ndevenish/PWMControl/Adv_PWM.kicad_pcb

## KiCad design Adv_PWM.kicad_pcb (2017-04-24)

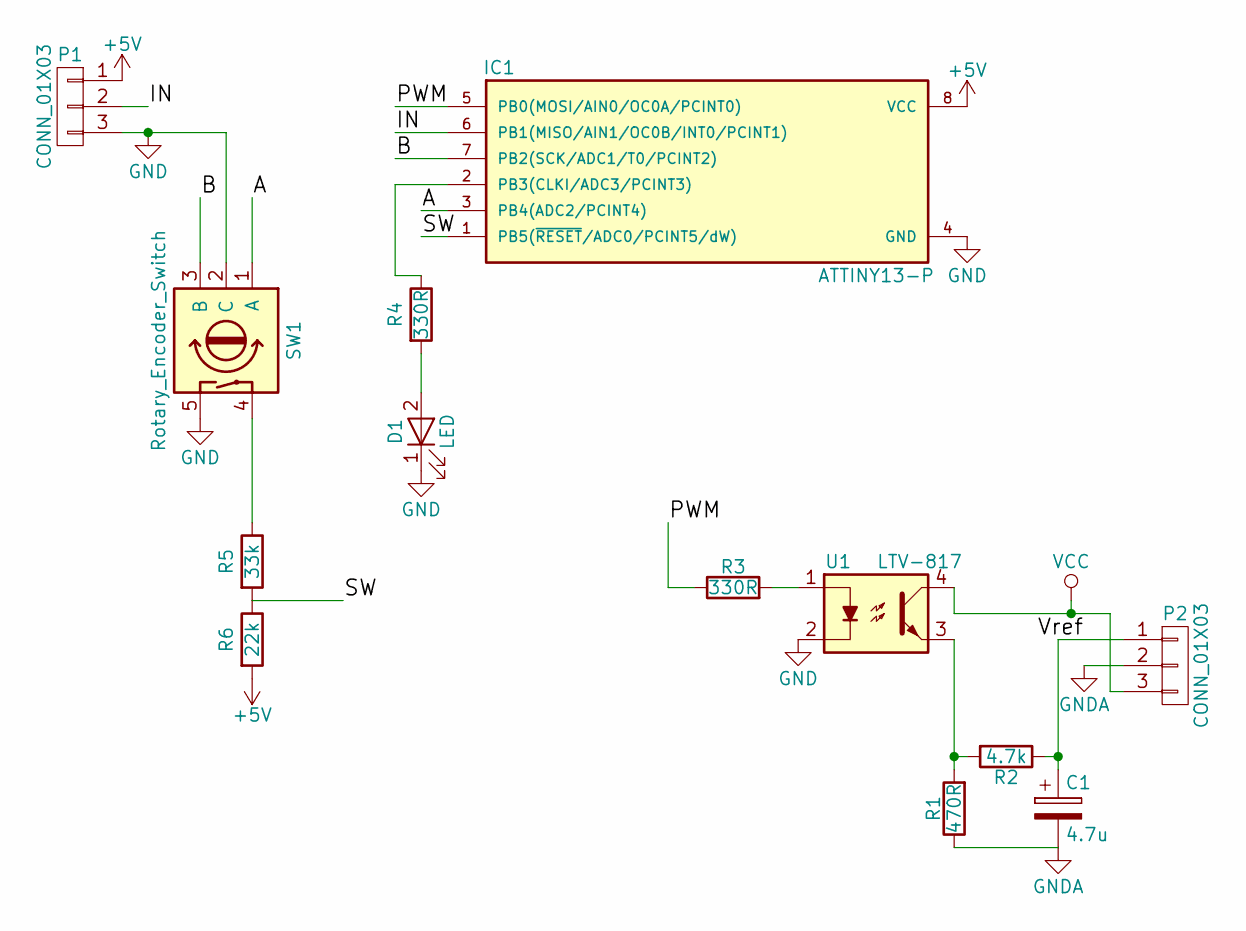
[picture p1: schematic Adv_PWM.sch]

Parts:
C1: 4.7u; CP_Radial_D5.0mm_P2.50mm
D1: LED; LED_D3.0mm
IC1: ATTINY13-P; DIP-8_W7.62mm
P1, P2: CONN_01X03; Pin_Header_Straight_1x03_Pitch2.54mm
R1: 470R; R_Axial_DIN0204_L3.6mm_D1.6mm_P5.08mm_Horizontal
R2: 4.7k; R_Axial_DIN0204_L3.6mm_D1.6mm_P5.08mm_Horizontal
R3: 330R; R_Axial_DIN0204_L3.6mm_D1.6mm_P5.08mm_Horizontal
R4: 330R; R_0805_HandSoldering
R5: 33k; R_Axial_DIN0204_L3.6mm_D1.6mm_P5.08mm_Horizontal
R6: 22k; R_Axial_DIN0204_L3.6mm_D1.6mm_P5.08mm_Horizontal
SW1: Rotary_Encoder_Switch; Rotary
U1: LTV-817; DIP-4_W7.62mm

Connections:
+5V: IC1.8 (VCC), P1.1, R6.2
/A: IC1.3 (PB4(ADC2/PCINT4)), SW1.1 (A)
/B: IC1.7 (PB2(SCK/ADC1/T0/PCINT2)), SW1.3 (B)
/IN: IC1.6 (PB1(MISO/AIN1/OC0B/INT0/PCINT1)), P1.2
/PWM: IC1.5 (PB0(MOSI/AIN0/OC0A/PCINT0)), R3.1
/SW: IC1.1 (PB5(~RESET~/ADC0/PCINT5/dW)), R5.2, R6.1
/Vref: C1.1, P2.1, R2.1
GND: D1.1 (K), IC1.4 (GND), P1.3, SW1.2 (C), SW1.5, U1.2
GNDA: C1.2, P2.2, R1.1
unnamed: D1.2 (A), R4.2
unnamed: IC1.2 (PB3(CLKI/ADC3/PCINT3)), R4.1
unnamed: R1.2, R2.2, U1.3
unnamed: R3.2, U1.1
unnamed: R5.1, SW1.4
VCC: P2.3, U1.4

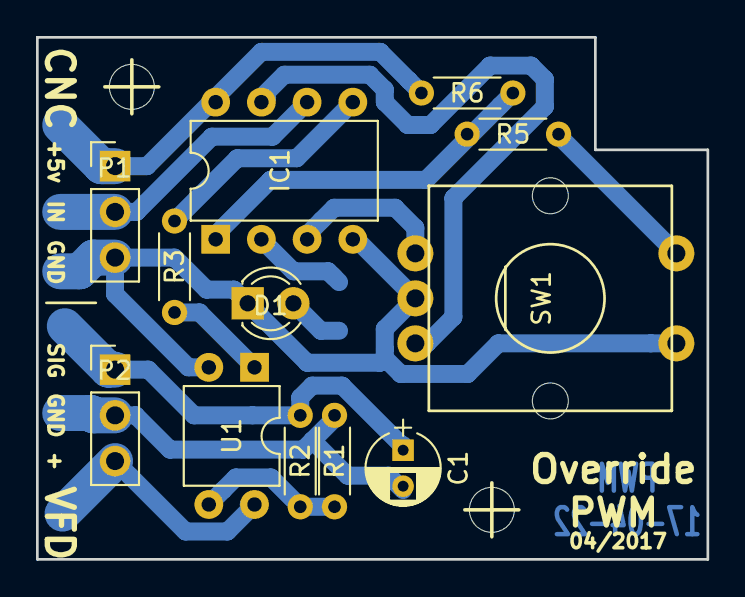
[picture p2: board Adv_PWM.kicad_pcb from above]

Board: 2 copper layers, 37.2 x 29.0 mm, 13 parts (1 on the bottom side), 15 nets.
