ndevenish/PWMControl/(commit log)

2017-04-16 Original cut
    [Adv_PWM.kicad_pcb, Adv_PWM.sch]
2017-04-16 INT0 changes
    [Adv_PWM.kicad_pcb, Adv_PWM.sch]
2017-04-22 Compactify a little more
    This includes adding a single surface mount resistor!
    [Adv_PWM.kicad_pcb, Adv_PWM.sch]
2017-04-22 Add the millproject file for PCB2GCode
2017-04-22 Switch the PWM output to a clock pin
    [Adv_PWM.kicad_pcb, Adv_PWM.sch]
2017-04-22 Use Voltage Divider on reset pin
    this means that we no longer need the reset fuse to be set, allowing
    reprogramming when testing. This required the swapping of pins and a
    slightly more complicated board.
    [Adv_PWM.kicad_pcb, Adv_PWM.sch]
2017-04-24 Change the capacitor footprint to be smaller
    [Adv_PWM.kicad_pcb]
2017-04-24 Rename silkscreen label
    [Adv_PWM.kicad_pcb]
2017-04-24 First draft of pwm reading with stimfile
2017-04-24 Write the pulse-read code in assembly for timing
    Both high and low-reading loops need to be exactly the same length in
    clock ticks
2017-04-24 Tidy assembly and abstract loop size
2017-04-24 Correct faulty inverting logic in assembly
2017-04-24 Fix for 100% duty cycle overflow
    [pwm.c]
2017-04-24 Fix the asm source file for the inverting logic
    [pwm_read_asm.c]
2017-04-24 Fix PWM duty cycle calculation
    [pwm.c]
2017-04-24 More assembly descriptions
2017-04-24 Scale back the timer when speeding up the CPU
    That way, the PWM output will stay stable and at the same frequency
    (4.7KHz at the moment)
2017-04-25 Start writing an alternative, interrupt-based PWM reader
    This is controlled by a preprocessor flag in the header
2017-04-25 Ignore pdf files in gerber folder
